LouisNikolaus/GFS---CO2-Ampel/CO2-Box-mit-Summer-und-OLed/Dokumentation/CO2-Box_Platine_Vorschau.png

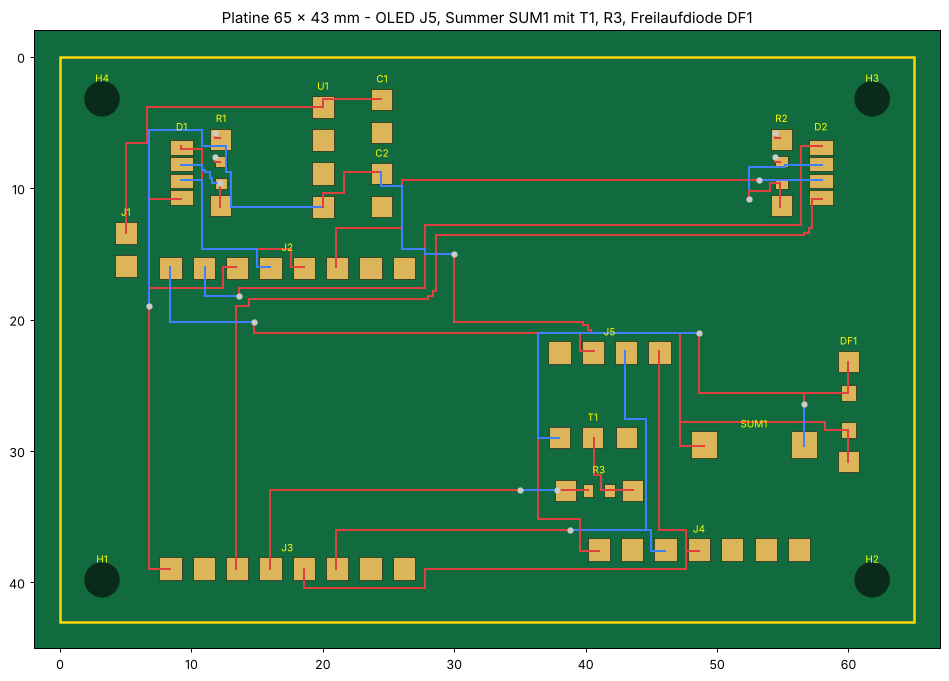
CO2-Box-mit-Summer-und-OLed/Dokumentation/CO2-Box_Platine_Vorschau.png
