LouisNikolaus/GFS---CO2-Ampel/gehaeuse/Vorschau.png

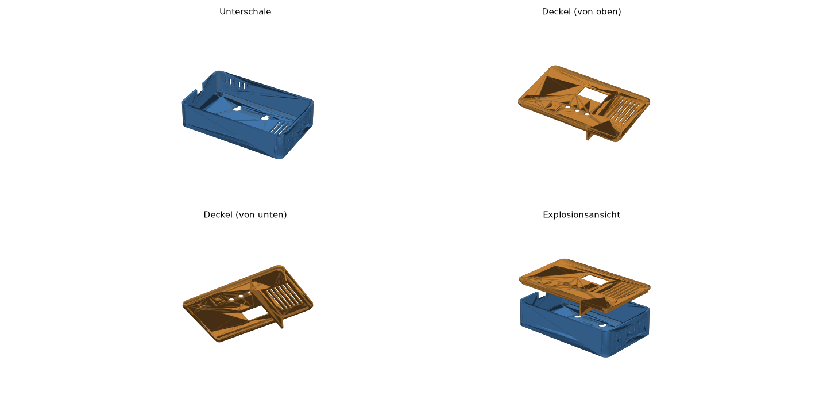
gehaeuse/Vorschau.png
