LouisNikolaus/GFS---CO2-Ampel/Platine/fertigung/Platine_oben.png

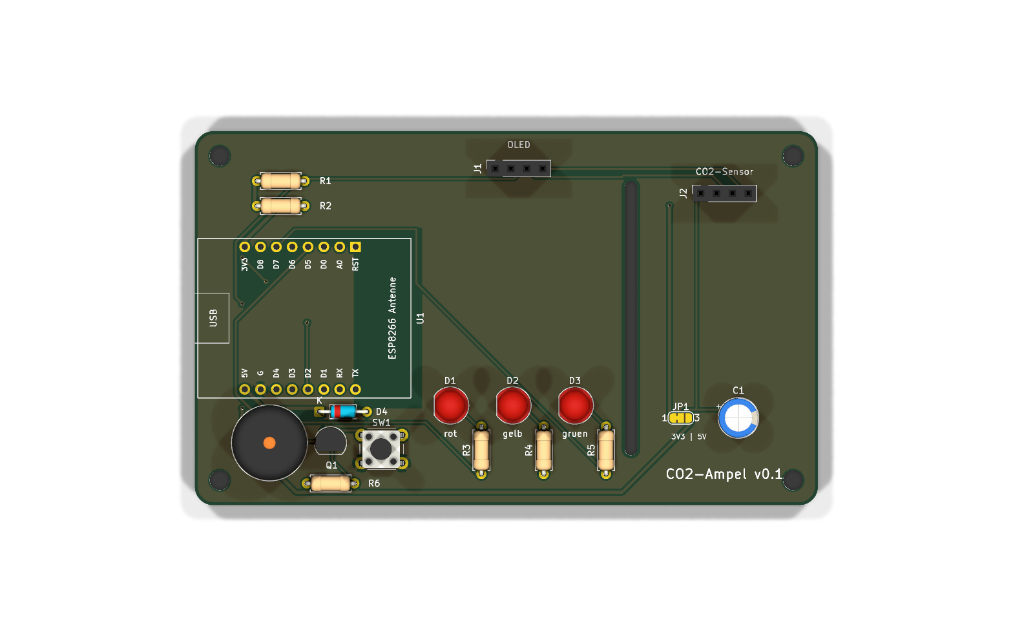
Platine/fertigung/Platine_oben.png
