LouisNikolaus/GFS---CO2-Ampel/Platine/fertigung/Platine_unten.png

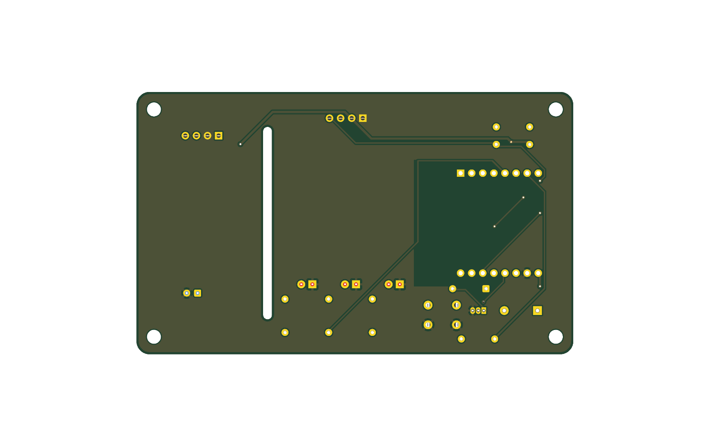
Platine/fertigung/Platine_unten.png
