LouisNikolaus/GFS---CO2-Ampel/materialliste.pdf

# Materialliste – ESP8266/SHT30-Platine (65 × 43 mm)

Pos | Bauteil | Wert / Typ | Meng e | Bemerkung
ESP | ESP8266-Board | Wemos D1 mini (oder kompatibel) | 1 | mit USB-Buchse und Reset-Taster
J2, J3 | Buchsenleiste 1x8, RM 2,54 | gerade | 2 | fuer das ESP-Board
U1 | Spannungsregler-Modul | MP1584 Mini-Step-down (Eingang bis 28 V) | 1 | auf 5,0 V einstellen
U1 | Stiftleiste 1x4, RM 2,54 | gerade | 1 | optional, zum Anschluss des Moduls
C1 | Elko radial, bedrahtet | 10 uF / 50 V, D 5 mm, RM 2,5 | 1 | Plus an Pad 1
C2 | Elko radial, bedrahtet | 10 uF / 16 V, D 5 mm, RM 2,5 | 1 | Plus an Pad 1
J1 | Stiftleiste 1x2 gewinkelt, RM 2,54 | 24-V-Eingang | 1 | plus passender Stecker/Kabel
J4 | Stiftleiste 1x7, RM 2,54 | zum Sensor-Modul | 1
SHT30 | Sensor-Modul | SHT30 Breakout mit 7 Pins | 1 | eigene Platine
D1, D2 | RGB-LED 5 mm | gemeinsame Kathode, 4 Beinchen | 2
R1, R2 | Widerstand 0603 SMD | 150 Ohm | 2 | je ein Vorwiderstand im Minus
