LouisNikolaus/GFS---CO2-Ampel/Platine/fertigung/Stueckliste.csv

Reference | Value | Footprint | QUANTITY
BZ1 | Summer 5V aktiv | Buzzer_Beeper:Buzzer_12x9.5RM7.6 | 1
C1 | 100uF | Capacitor_THT:CP_Radial_D6.3mm_P2.50mm | 1
D1 | LED 5mm rot | LED_THT:LED_D5.0mm | 1
D2 | LED 5mm gelb | LED_THT:LED_D5.0mm | 1
D3 | LED 5mm gruen | LED_THT:LED_D5.0mm | 1
D4 | 1N4148 | Diode_THT:D_DO-35_SOD27_P7.62mm_Horizontal | 1
J1 | OLED 0,96" SSD1306 | Connector_PinSocket_2.54mm:PinSocket_1x04_P2.54mm_Vertical | 1
J2 | CO2-Sensor I2C | Connector_PinSocket_2.54mm:PinSocket_1x04_P2.54mm_Vertical | 1
Q1 | BC547 | Package_TO_SOT_THT:TO-92_Inline | 1
R1,R2 | 4k7 (opt.) | Resistor_THT:R_Axial_DIN0207_L6.3mm_D2.5mm_P7.62mm_Horizontal | 2
R3-R5 | 220 | Resistor_THT:R_Axial_DIN0207_L6.3mm_D2.5mm_P7.62mm_Horizontal | 3
R6 | 1k | Resistor_THT:R_Axial_DIN0207_L6.3mm_D2.5mm_P7.62mm_Horizontal | 1
SW1 | Taster | Button_Switch_THT:SW_PUSH_6mm_H13mm | 1
U1 | D1 mini (ESP8266) | CO2:WEMOS_D1_mini | 1
