LouisNikolaus/GFS---CO2-Ampel/CO2-Box-mit-Summer-und-OLed/Gehaeuse/CO2-Box_Gehaeuse_Unterteil.stl

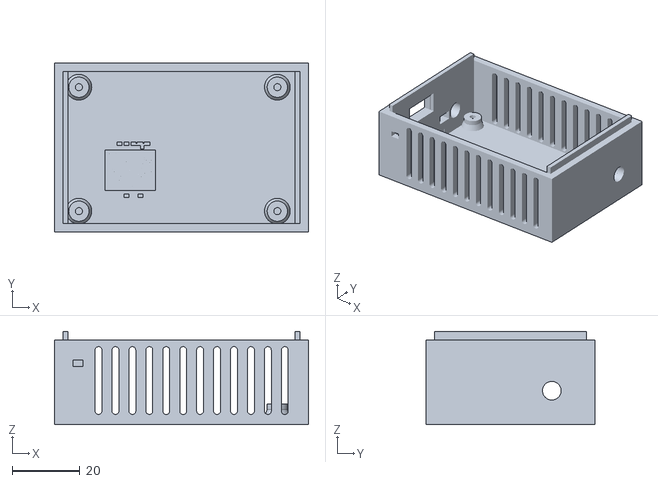
[picture p5: CAD file, 2026-11-02]
CO2-Box-mit-Summer-und-OLed/Gehaeuse/CO2-Box_Gehaeuse_Unterteil.stl
75.0 x 50.0 x 27.5
