LouisNikolaus/GFS---CO2-Ampel/gehaeuse/Deckel.stl

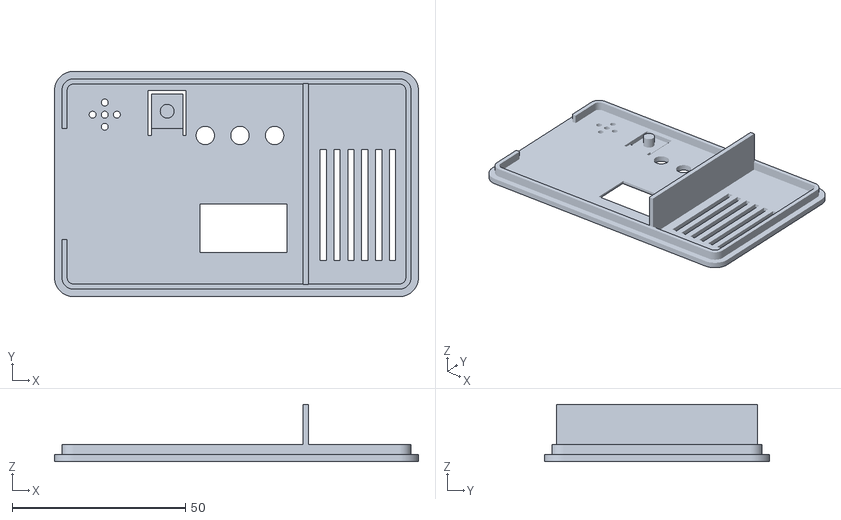
[picture p6: CAD file, 2026-09-30]
gehaeuse/Deckel.stl
105.0 x 65.0 x 16.5
