LouisNikolaus/GFS---CO2-Ampel/CO2-Box-mit-Summer-und-OLed/Gehaeuse/CO2-Box_Deckel_Raum-1.21_komplett_Filamentwechsel.stl

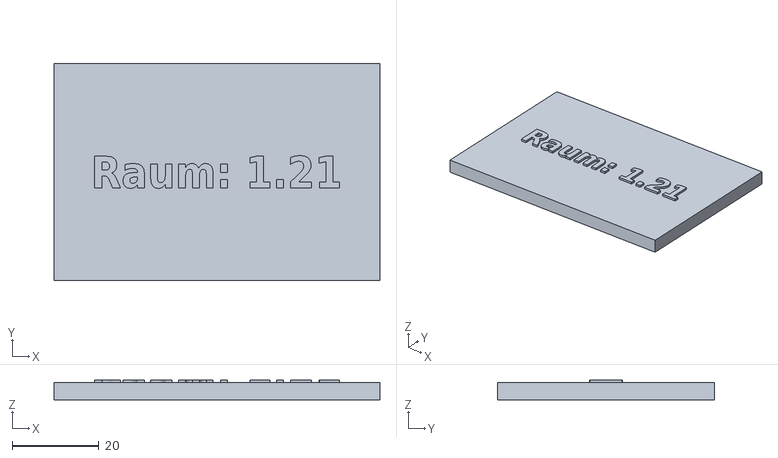
[picture p7: CAD file, 2026-11-02]
CO2-Box-mit-Summer-und-OLed/Gehaeuse/CO2-Box_Deckel_Raum-1.21_komplett_Filamentwechsel.stl
75.0 x 50.0 x 4.60
