LouisNikolaus/GFS---CO2-Ampel/gehaeuse/Zusammenbau_Vorschau.stl

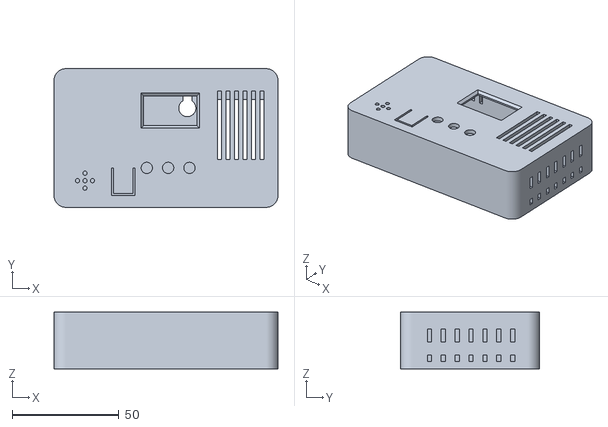
[picture p8: CAD file, 2026-09-30]
gehaeuse/Zusammenbau_Vorschau.stl
105.0 x 65.0 x 26.6
