LouisNikolaus/GFS---CO2-Ampel/CO2-Box-mit-Summer-und-OLed/Gehaeuse/CO2-Box_Deckel_Raum-1.21_Schrift_hellgrau.stl

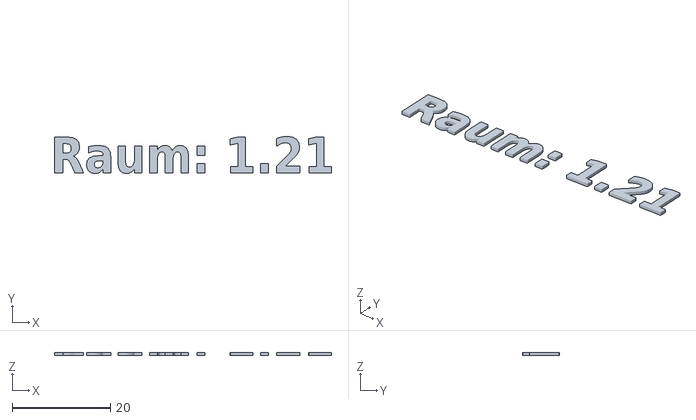
[picture p9: CAD file, 2026-11-02]
CO2-Box-mit-Summer-und-OLed/Gehaeuse/CO2-Box_Deckel_Raum-1.21_Schrift_hellgrau.stl
56.3 x 7.56 x 0.6
