LouisNikolaus/GFS---CO2-Ampel/gehaeuse/Unterschale.stl

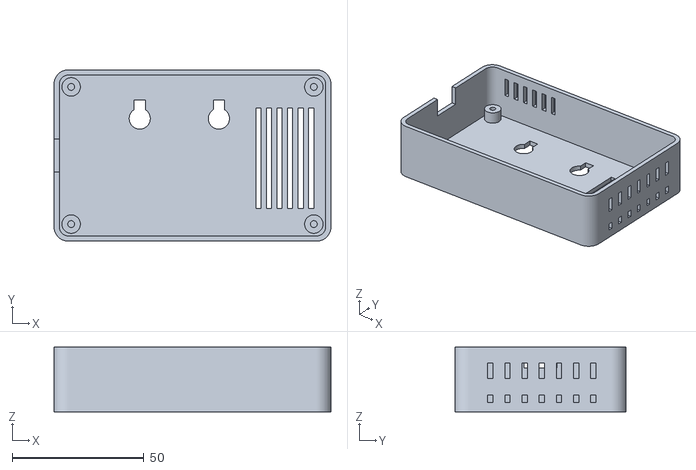
[picture p10: CAD file, 2026-09-30]
gehaeuse/Unterschale.stl
105.0 x 65.0 x 24.6
