LouisNikolaus/GFS---CO2-Ampel/CO2-Box-mit-Summer-und-OLed/Gehaeuse/CO2-Box_Deckel_Raum-1.21_schwarz.stl

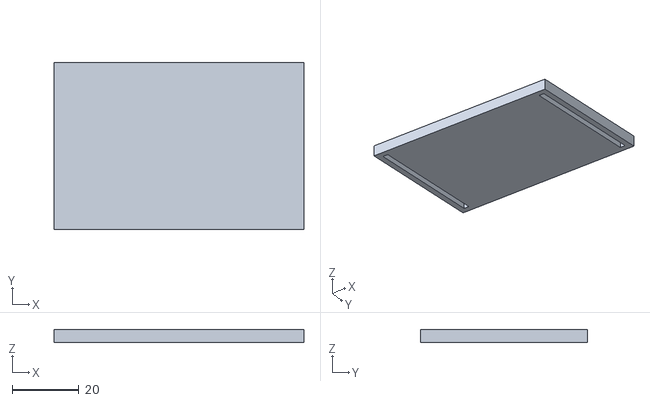
[picture p11: CAD file, 2026-11-02]
CO2-Box-mit-Summer-und-OLed/Gehaeuse/CO2-Box_Deckel_Raum-1.21_schwarz.stl
75.0 x 50.0 x 4.00
