LouisNikolaus/GFS---CO2-Ampel/Platine/CO2-Ampel_Schaltplan.pdf

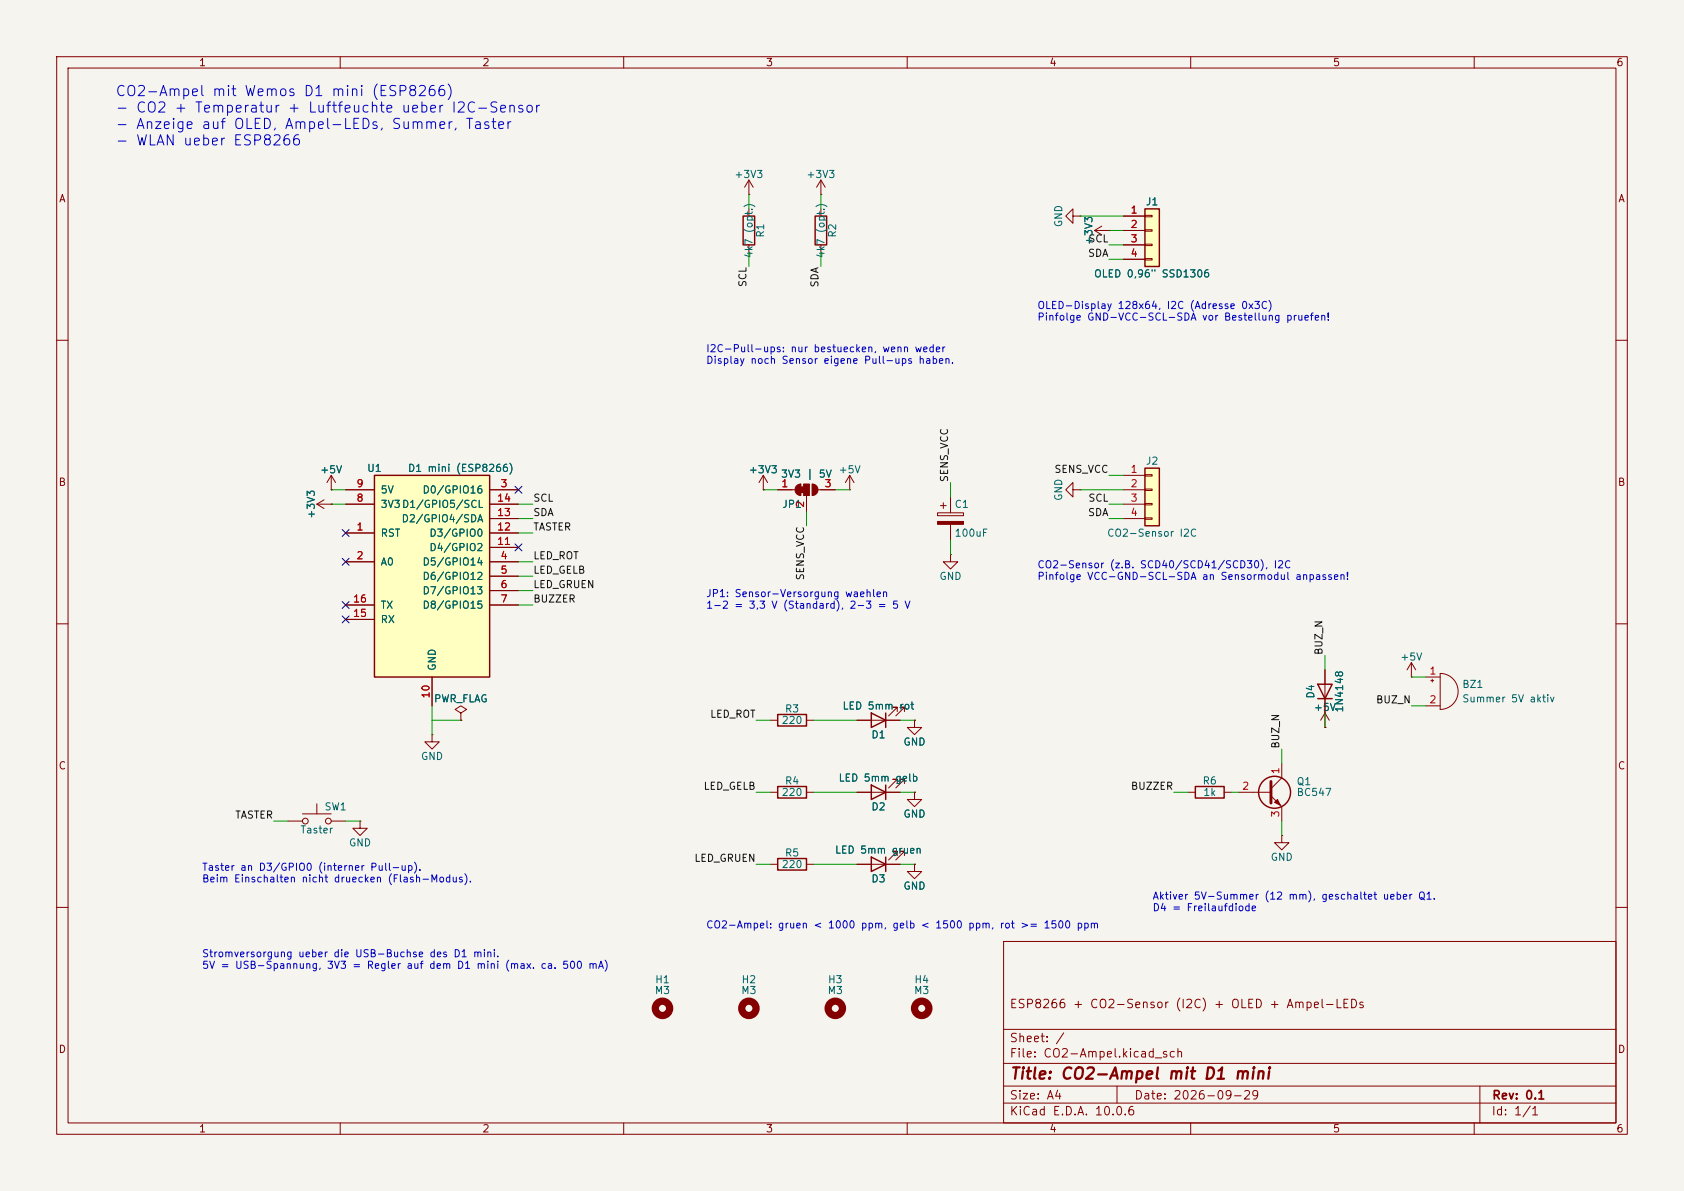
[picture p12: page 1]

CO2-Ampel mit Wemos D1 mini (ESP8266) - CO2 + Temperatur + Luftfeuchte ueber I2C-Sensor - Anzeige auf OLED, Ampel-LEDs, Summer, Taster - WLAN ueber ESP8266

OLED-Display 128x64, I2C (Adresse 0x3C)
Pinfolge GND-VCC-SCL-SDA vor Bestellung pruefen!

Pinfolge VCC-GND-SCL-SDA an Sensormodul anpassen!
LED 5mm rot GND

CO2-Ampel: gruen < 1000 ppm, gelb < 1500 ppm, rot >= 1500 ppm

ESP8266 + CO2-Sensor (I2C) + OLED + Ampel-LEDs

Sheet: /
File: CO2-Ampel.kicad_sch
Title: CO2-Ampel mit D1 mini

Size: A4 | Rev: 0.1
KiCad E.D.A. 10.0.6 | Id: 1/1
