LouisNikolaus/GFS---CO2-Ampel/Platine/fertigung/Platine_Layout.pdf

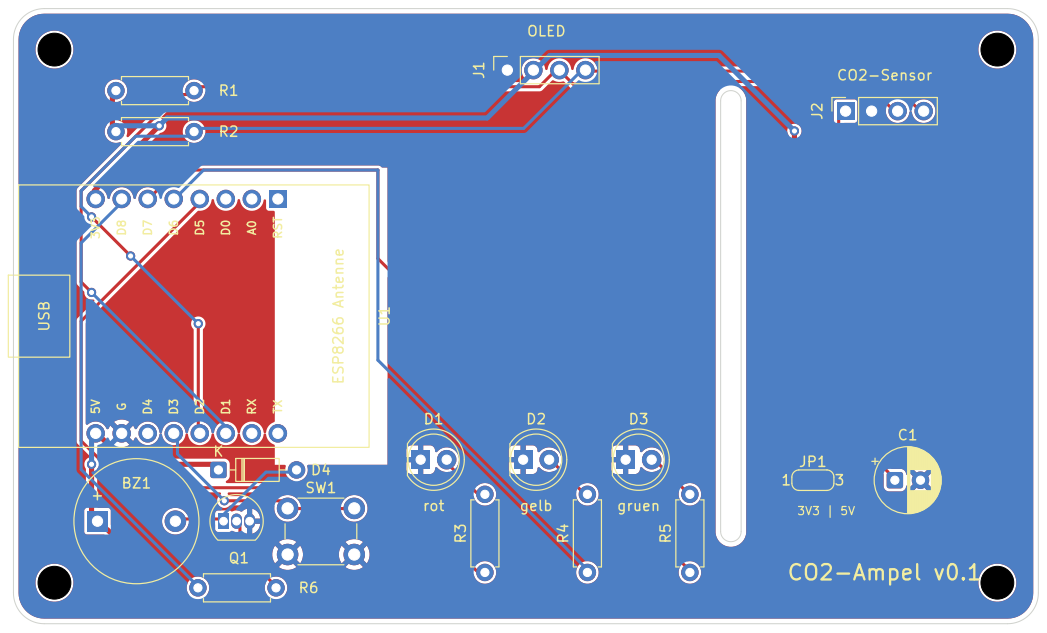
[picture p13: page 1]
