LouisNikolaus/GFS---CO2-Ampel/Platine/CO2-Ampel.kicad_pcb

## KiCad design Platine/CO2-Ampel.kicad_pcb (2026-09-30)

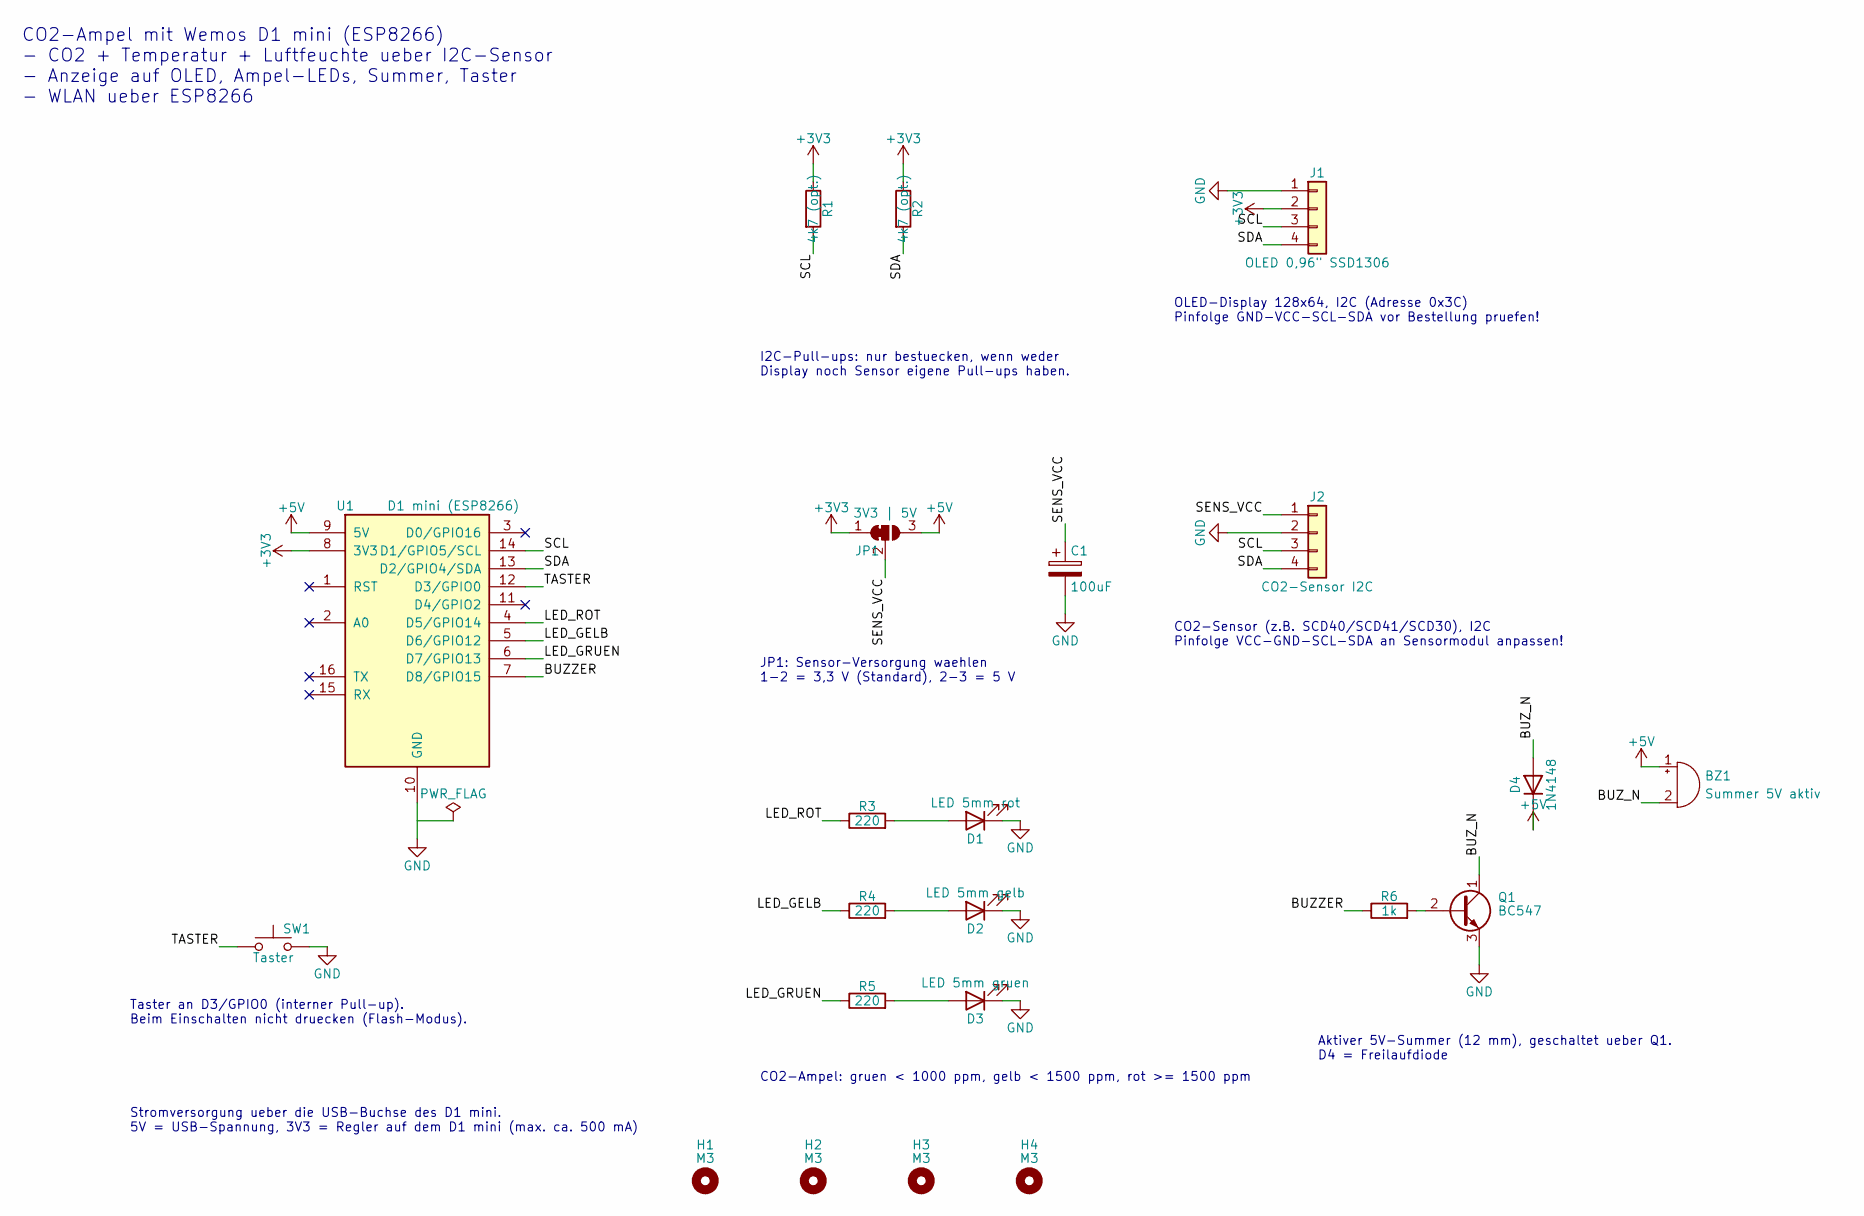
[picture p14: schematic CO2-Ampel.kicad_sch, CO2-Ampel mit D1 mini]

Parts:
BZ1: Summer 5V aktiv; Buzzer_12x9.5RM7.6
C1: 100uF; CP_Radial_D6.3mm_P2.50mm
D1: LED 5mm rot; LED_D5.0mm
D2: LED 5mm gelb; LED_D5.0mm
D3: LED 5mm gruen; LED_D5.0mm
D4: 1N4148; D_DO-35_SOD27_P7.62mm_Horizontal
H1, H2, H3, H4: M3; MountingHole_3.2mm_M3
J1: OLED 0,96" SSD1306; PinSocket_1x04_P2.54mm_Vertical
J2: CO2-Sensor I2C; PinSocket_1x04_P2.54mm_Vertical
JP1: 3V3 | 5V; SolderJumper-3_P1.3mm_Bridged12_RoundedPad1.0x1.5mm_NumberL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
Q1: BC547; TO-92_Inline
R1, R2: 4k7 (opt.); R_Axial_DIN0207_L6.3mm_D2.5mm_P7.62mm_Horizontal
R3, R4, R5: 220; R_Axial_DIN0207_L6.3mm_D2.5mm_P7.62mm_Horizontal
R6: 1k; R_Axial_DIN0207_L6.3mm_D2.5mm_P7.62mm_Horizontal
SW1: Taster; SW_PUSH_6mm_H13mm
U1: D1 mini (ESP8266); WEMOS_D1_mini

Connections:
+3V3: J1.2, JP1.1 (A), R1.1, R2.1, U1.8 (3V3)
+5V: BZ1.1 (+), D4.1 (K), JP1.3 (B), U1.9 (5V)
/BUZZER: R6.1, U1.7 (D8/GPIO15)
/BUZ_N: BZ1.2 (-), D4.2 (A), Q1.1 (C)
/LED_GELB: R4.1, U1.5 (D6/GPIO12)
/LED_GRUEN: R5.1, U1.6 (D7/GPIO13)
/LED_ROT: R3.1, U1.4 (D5/GPIO14)
/SCL: J1.3, J2.3, R1.2, U1.14 (D1/GPIO5/SCL)
/SDA: J1.4, J2.4, R2.2, U1.13 (D2/GPIO4/SDA)
/SENS_VCC: C1.1, J2.1, JP1.2 (C)
/TASTER: SW1.1, U1.12 (D3/GPIO0)
GND: C1.2, D1.1 (K), D2.1 (K), D3.1 (K), J1.1, J2.2, Q1.3 (E), SW1.2, U1.10 (GND)
unnamed: D1.2 (A), R3.2
unnamed: D2.2 (A), R4.2
unnamed: D3.2 (A), R5.2
unnamed: Q1.2 (B), R6.2

Notes on the sheet:
Stromversorgung ueber die USB-Buchse des D1 mini. 5V = USB-Spannung, 3V3 = Regler auf dem D1 mini (max. ca. 500 mA)
I2C-Pull-ups: nur bestuecken, wenn weder Display noch Sensor eigene Pull-ups haben.
OLED-Display 128x64, I2C (Adresse 0x3C) Pinfolge GND-VCC-SCL-SDA vor Bestellung pruefen!
CO2-Sensor (z.B. SCD40/SCD41/SCD30), I2C Pinfolge VCC-GND-SCL-SDA an Sensormodul anpassen!
JP1: Sensor-Versorgung waehlen 1-2 = 3,3 V (Standard), 2-3 = 5 V
CO2-Ampel: gruen < 1000 ppm, gelb < 1500 ppm, rot >= 1500 ppm
Aktiver 5V-Summer (12 mm), geschaltet ueber Q1. D4 = Freilaufdiode
Taster an D3/GPIO0 (interner Pull-up). Beim Einschalten nicht druecken (Flash-Modus).
CO2-Ampel mit Wemos D1 mini (ESP8266) - CO2 + Temperatur + Luftfeuchte ueber I2C-Sensor - Anzeige auf OLED, Ampel-LEDs, Summer, Taster - WLAN ueber ESP8266

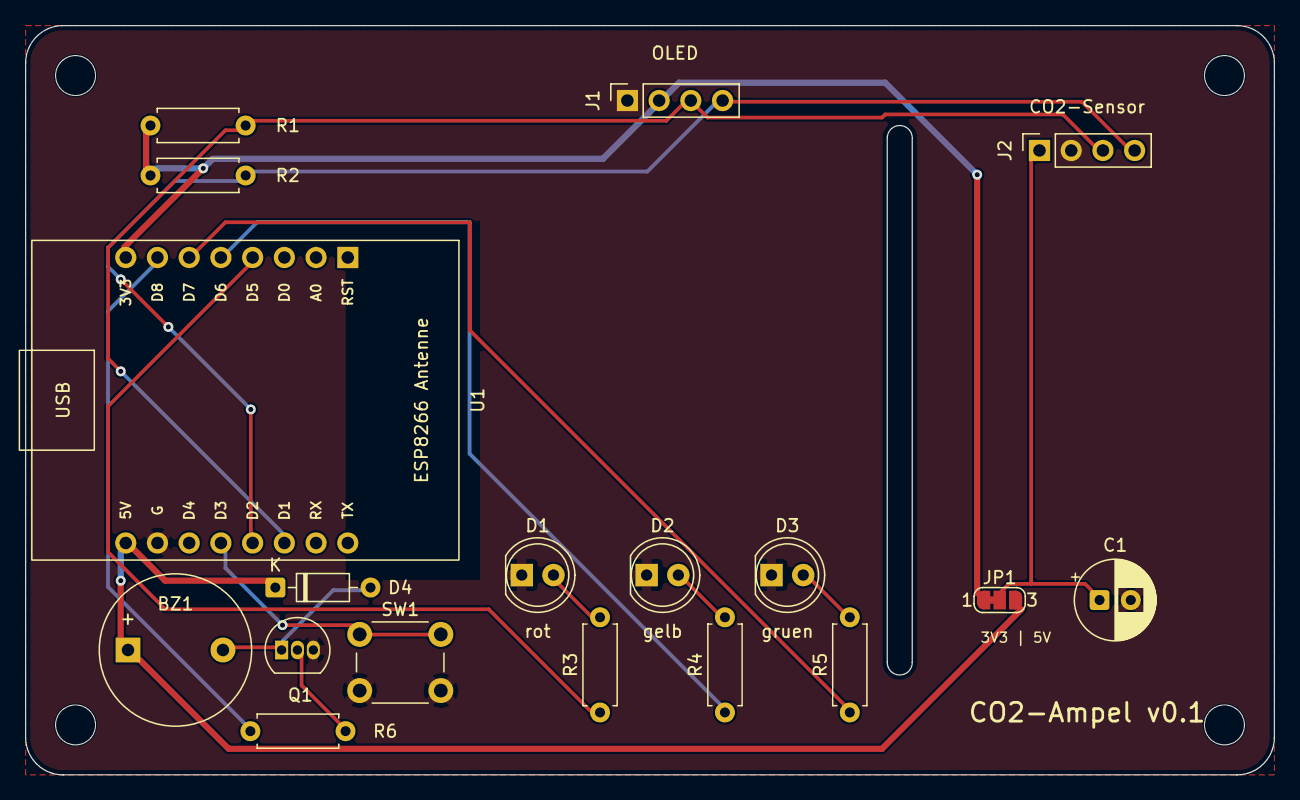
[picture p15: board CO2-Ampel.kicad_pcb from above]

Board: 2 copper layers, 100.0 x 60.0 mm, 22 parts (0 on the bottom side), 16 nets.
