LouisNikolaus/GFS---CO2-Ampel/CO2-Box-mit-Summer-und-OLed/Platine/CO2-Box_Platine.kicad_pcb

## KiCad design CO2-Box-mit-Summer-und-OLed/Platine/CO2-Box_Platine.kicad_pcb (2026-11-02)

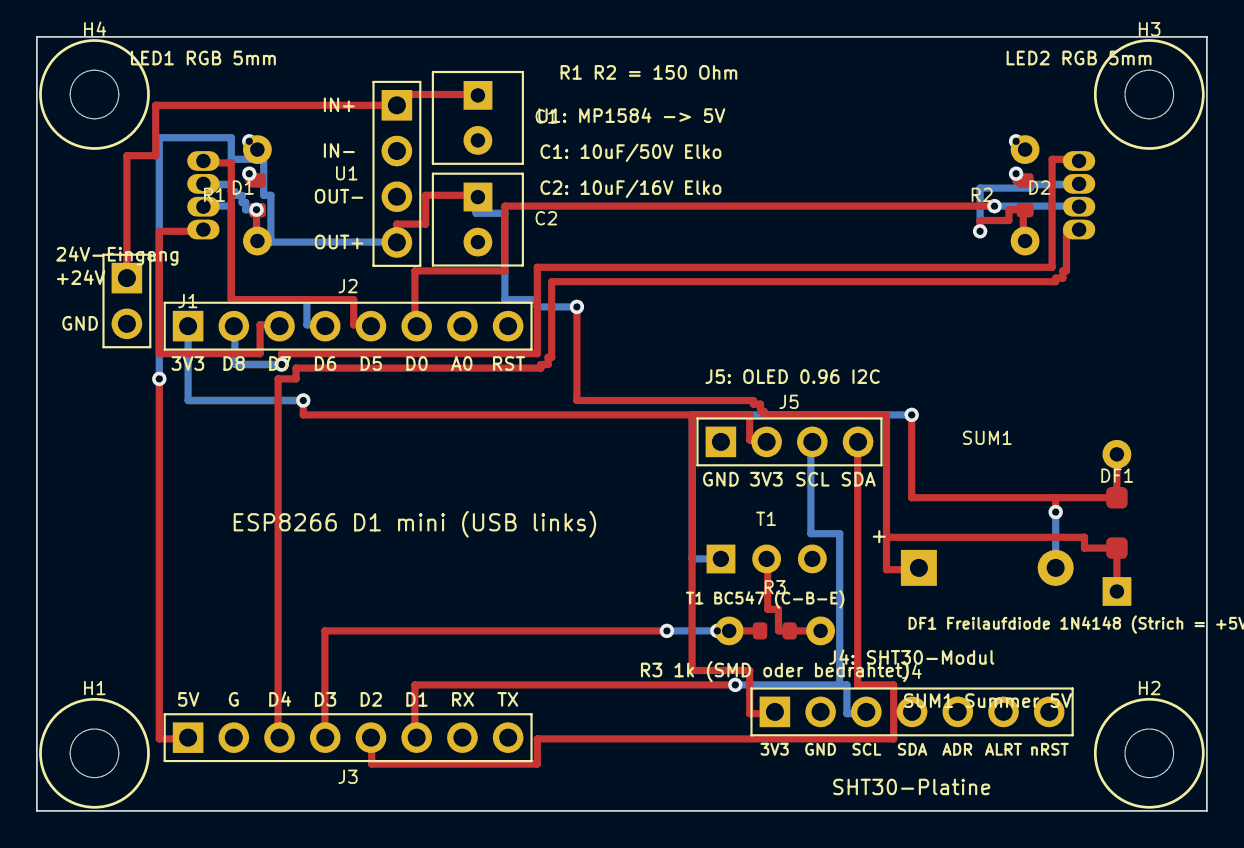
[picture p16: board CO2-Box_Platine.kicad_pcb from above]

Board: 2 copper layers, 65.0 x 43.0 mm, 20 parts (0 on the bottom side), 17 nets.

Parts:
C1: 10u/50V Elko; CP_Radial_D5.0mm_P2.50mm
C2: 10u/16V Elko; CP_Radial_D5.0mm_P2.50mm
D1: RGB links; LED_D5.0mm-4_RGB
D2: RGB rechts; LED_D5.0mm-4_RGB
DF1: 1N4148 Freilauf; D_DO-35_SOD27_P7.62mm_Horizontal
H1, H2, H3, H4: M2.5; MountingHole_2.7mm_M2.5
J1: 24V IN; PinHeader_1x02_P2.54mm_Horizontal
J2: ESP hinten; PinSocket_1x08_P2.54mm_Vertical
J3: ESP vorn; PinSocket_1x08_P2.54mm_Vertical
J4: SHT30-Platine; PinHeader_1x07_P2.54mm_Vertical
J5: OLED I2C; PinHeader_1x04_P2.54mm_Vertical
R1, R2: 150; R_Axial_DIN0207_L6.3mm_P5.08mm
R3: 1k; R_Axial_DIN0207_L6.3mm_P5.08mm
SUM1: Summer aktiv 5V; Buzzer_12x9.5RM7.6
T1: BC547 NPN; TO-92_Inline_Wide
U1: MP1584-Modul (auf 5V einstellen); PinHeader_1x04_P2.54mm_Vertical

Connections:
+3V3: J2.1, J4.1, J5.2
+5V: C2.1, DF1.1, J3.1, SUM1.1, U1.4
+24V: C1.1, J1.1, U1.1
BZ_N: DF1.2, SUM1.2, T1.1
D0: D2.3, J2.6
D3: J3.4, R3.1
D4: D2.4, J3.3
D5: D1.1, J2.5
D6: D1.3, J2.4
D7: D1.4, J2.3
D8: D2.1, J2.2
GND: C1.2, C2.2, J1.2, J3.2, J4.2, J5.1, R1.2, R2.2, T1.3, U1.2, U1.3
L1_K: D1.2, R1.1
L2_K: D2.2, R2.1
Q1_B: R3.2, T1.2
SCL: J3.6, J4.3, J5.3
SDA: J3.5, J4.4, J5.4
